OzoNeTT/eis-coursework/img/construction-top.jpg

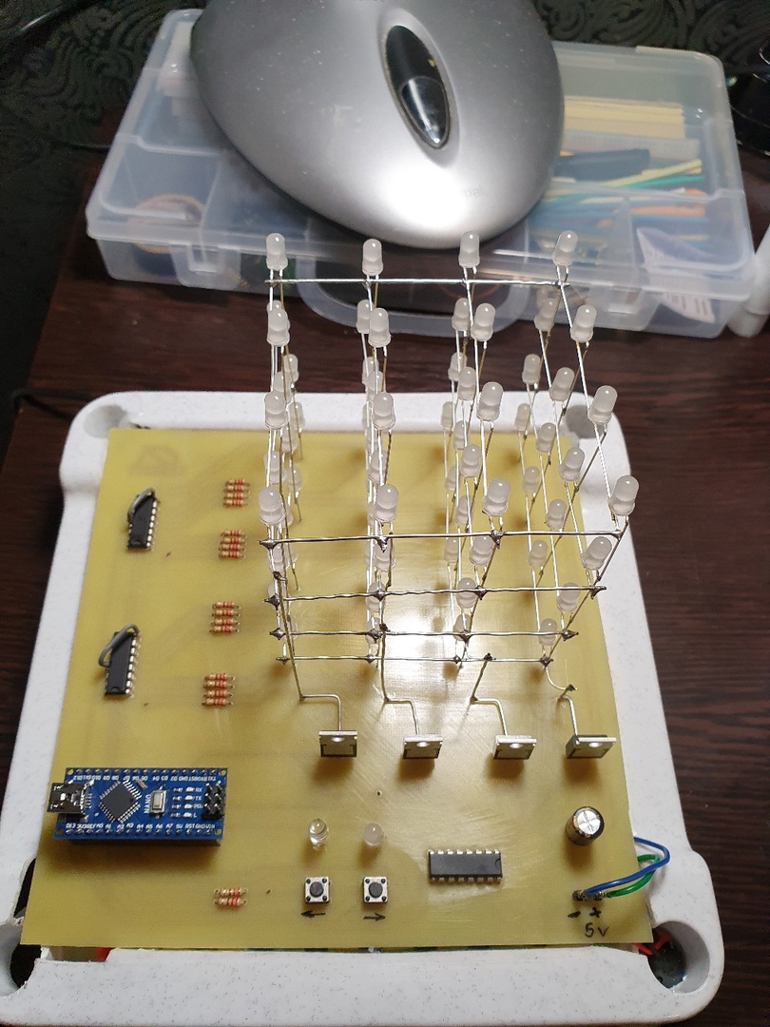
img/construction-top.jpg
