OzoNeTT/eis-coursework/img/construction-bottom.jpg

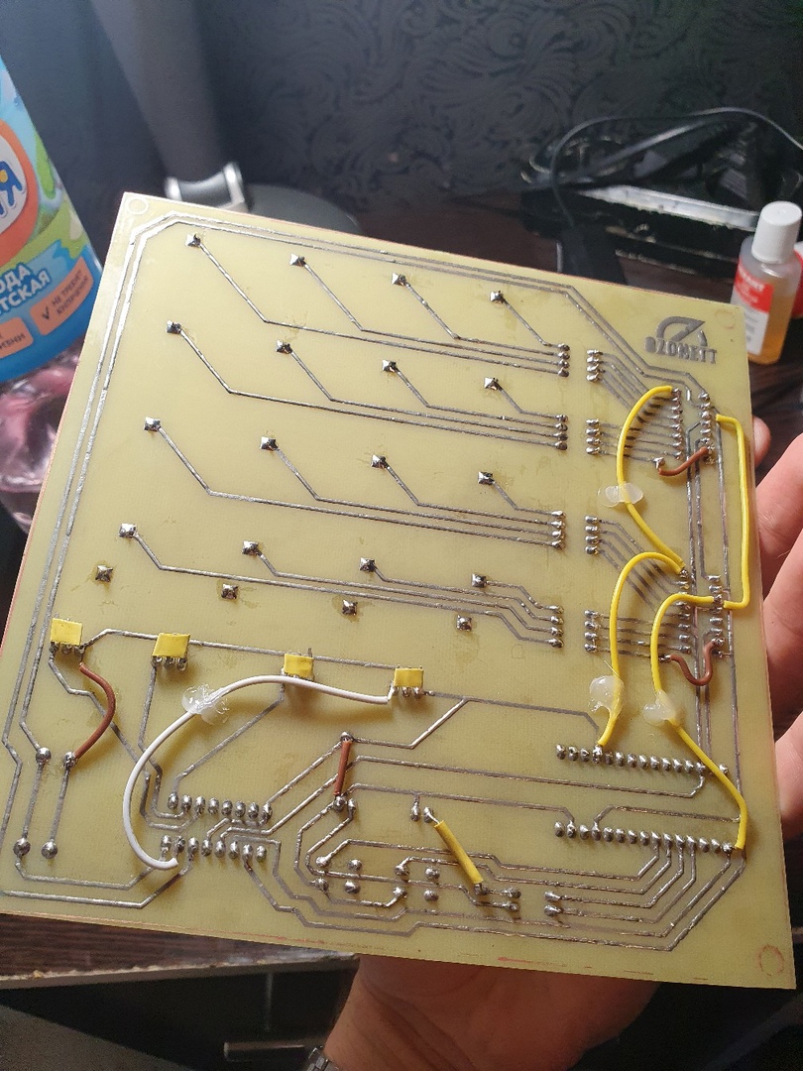
img/construction-bottom.jpg
