OzoNeTT/eis-coursework/README.md

# Курсовой проект по электронике и схемотехнике (6 семестр)

## Использование        

- Открыть редактор [EasyEDA](https://easyeda.com/editor)
- Выбрать "Document" > "Open" > "EasyEDA Source", и выбрать файлы формата `.json`

## Прошивка

Файл прошивки для Arduino Nano v3 расположен в директории `src`

## РПЗ

Расчетно-пояснительная записка расположена в директории `docs`

## Скриншоты 

Все фотографии конструкции и изображения распиновок и плат расположены в директории `img`
