OzoNeTT/eis-coursework/img/body-front.jpg

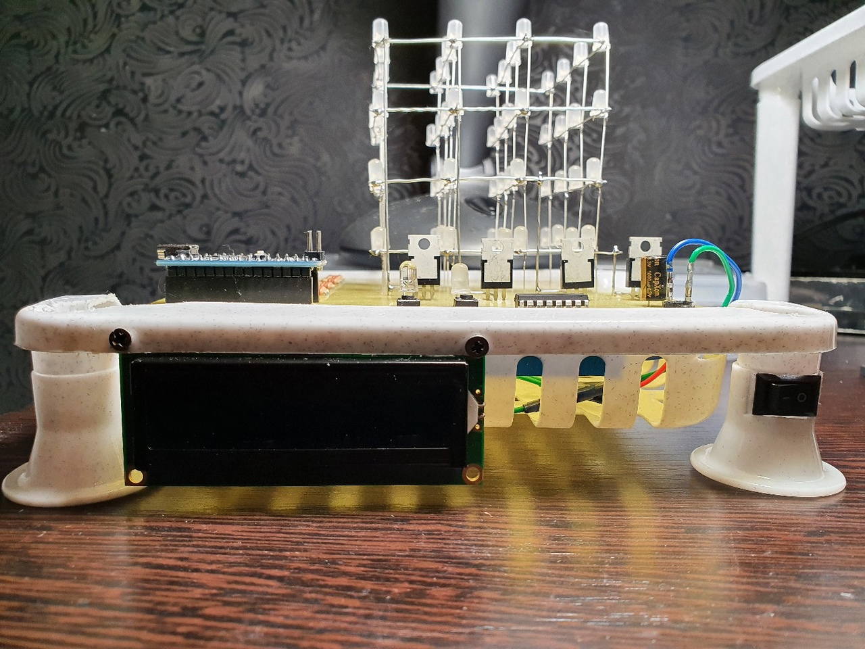
img/body-front.jpg
