OzoNeTT/eis-coursework/img/cube2.jpg

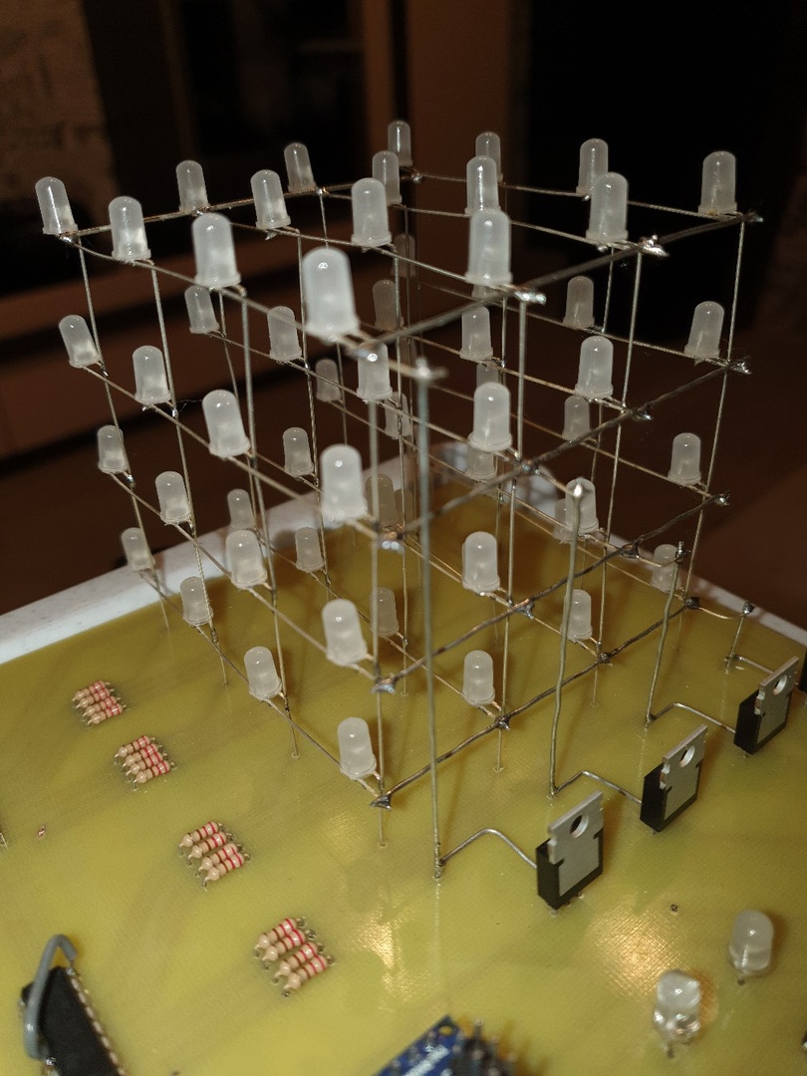
img/cube2.jpg
