OzoNeTT/eis-coursework/img/cube.jpg

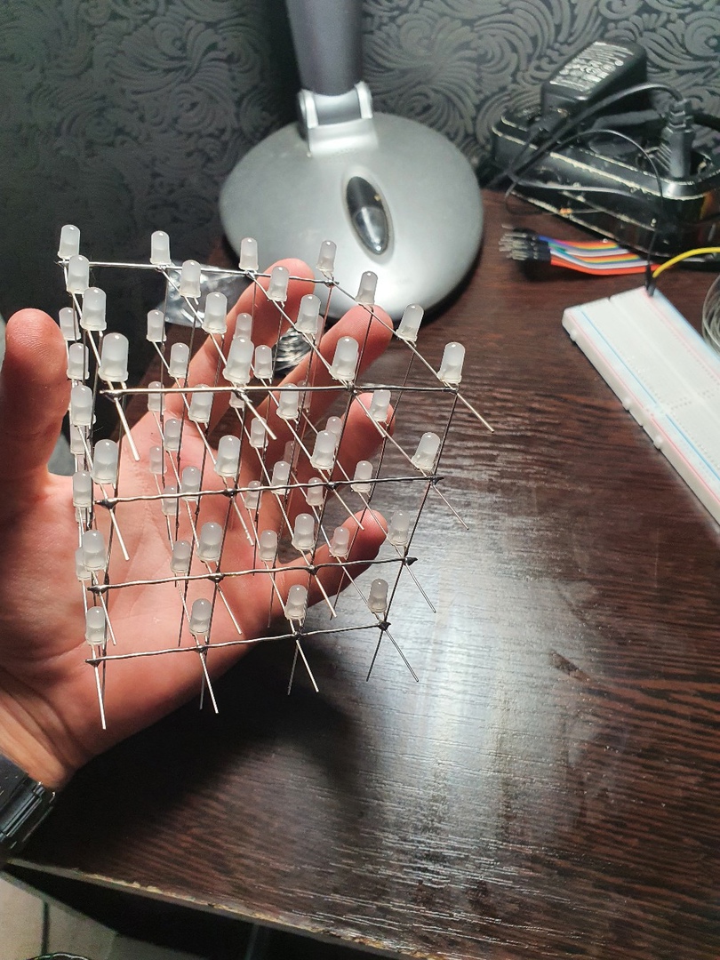
img/cube.jpg
