OzoNeTT/eis-coursework/img/final-view.jpg

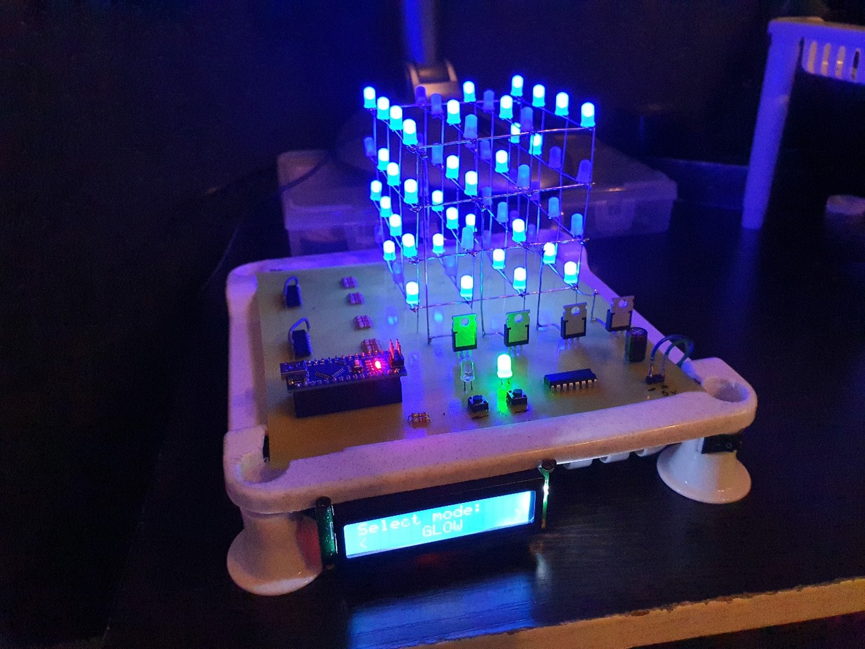
img/final-view.jpg
