OzoNeTT/eis-coursework/img/leds.png

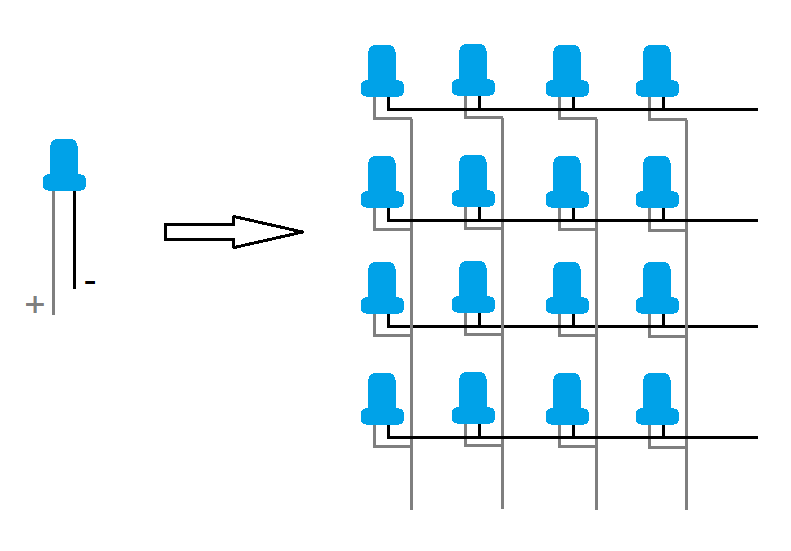
img/leds.png
