OzoNeTT/eis-coursework/img/main-circuit.png

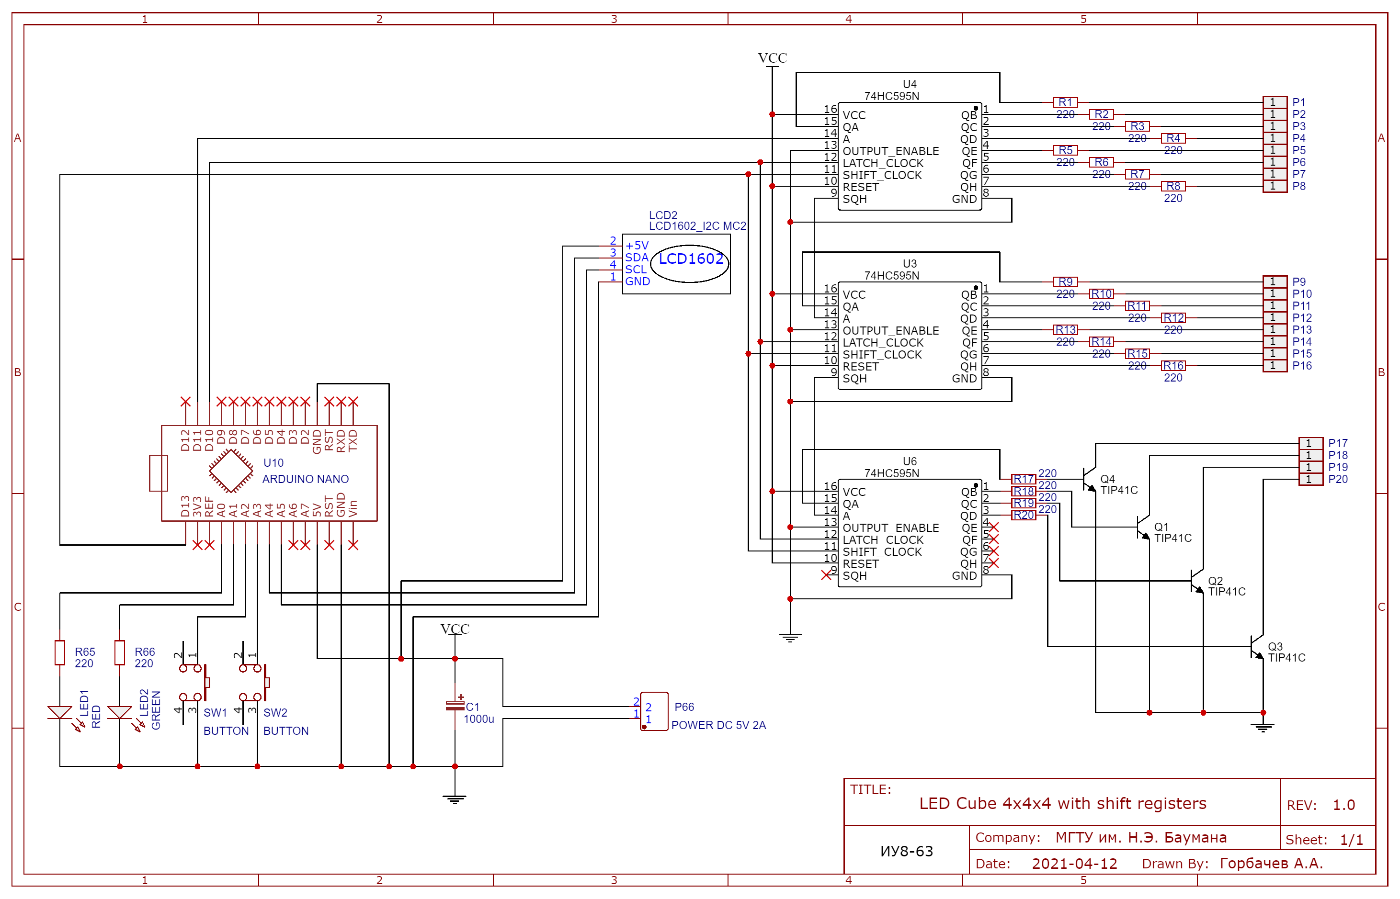
img/main-circuit.png
