OzoNeTT/eis-coursework/img/nano-pinout.png

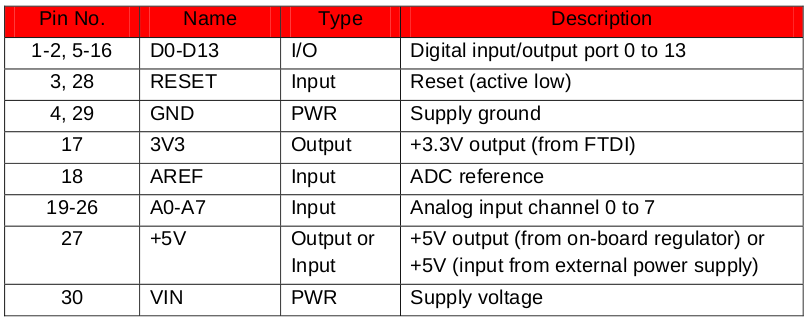
img/nano-pinout.png
