OzoNeTT/eis-coursework/img/nano-shema.png

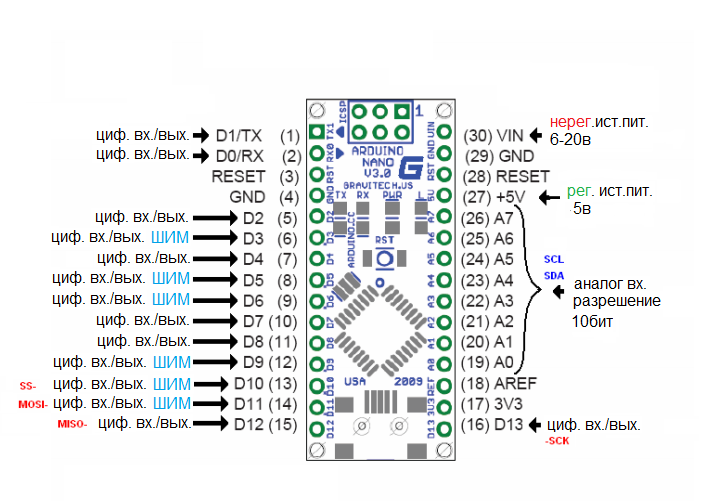
img/nano-shema.png
