OzoNeTT/eis-coursework/img/pcb1.jpg

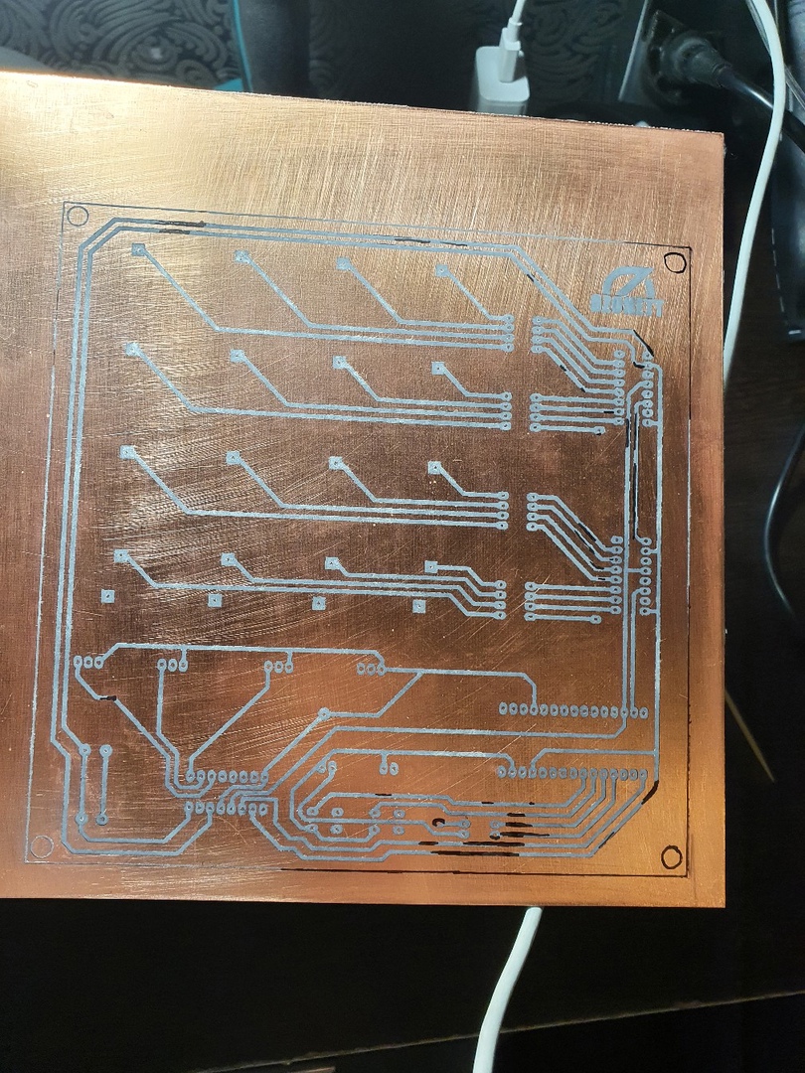
img/pcb1.jpg
