OzoNeTT/eis-coursework/img/pcb2.jpg

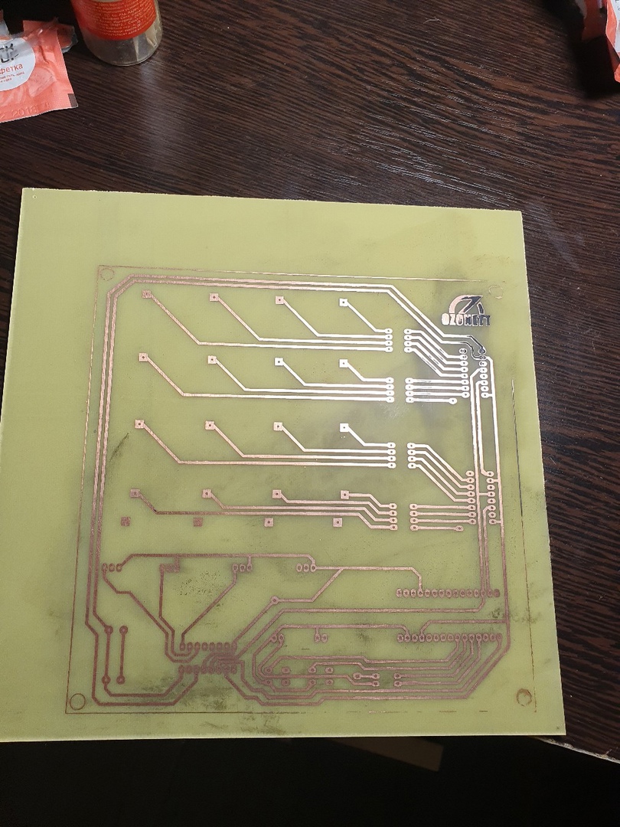
img/pcb2.jpg
