OzoNeTT/eis-coursework/img/pcb3.jpg

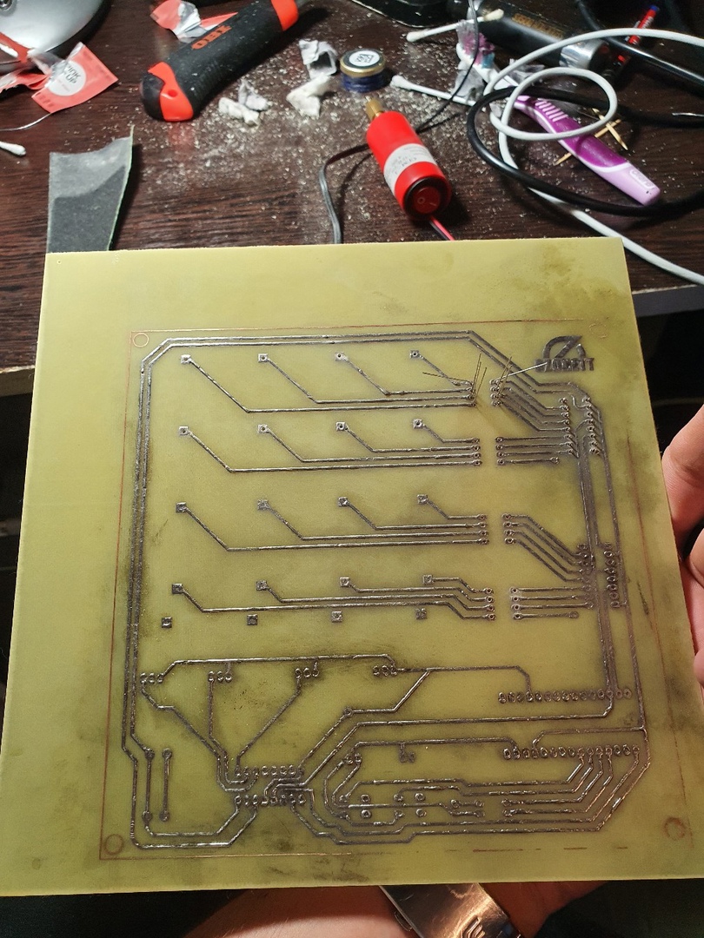
img/pcb3.jpg
