OzoNeTT/eis-coursework/img/pcb-top.png

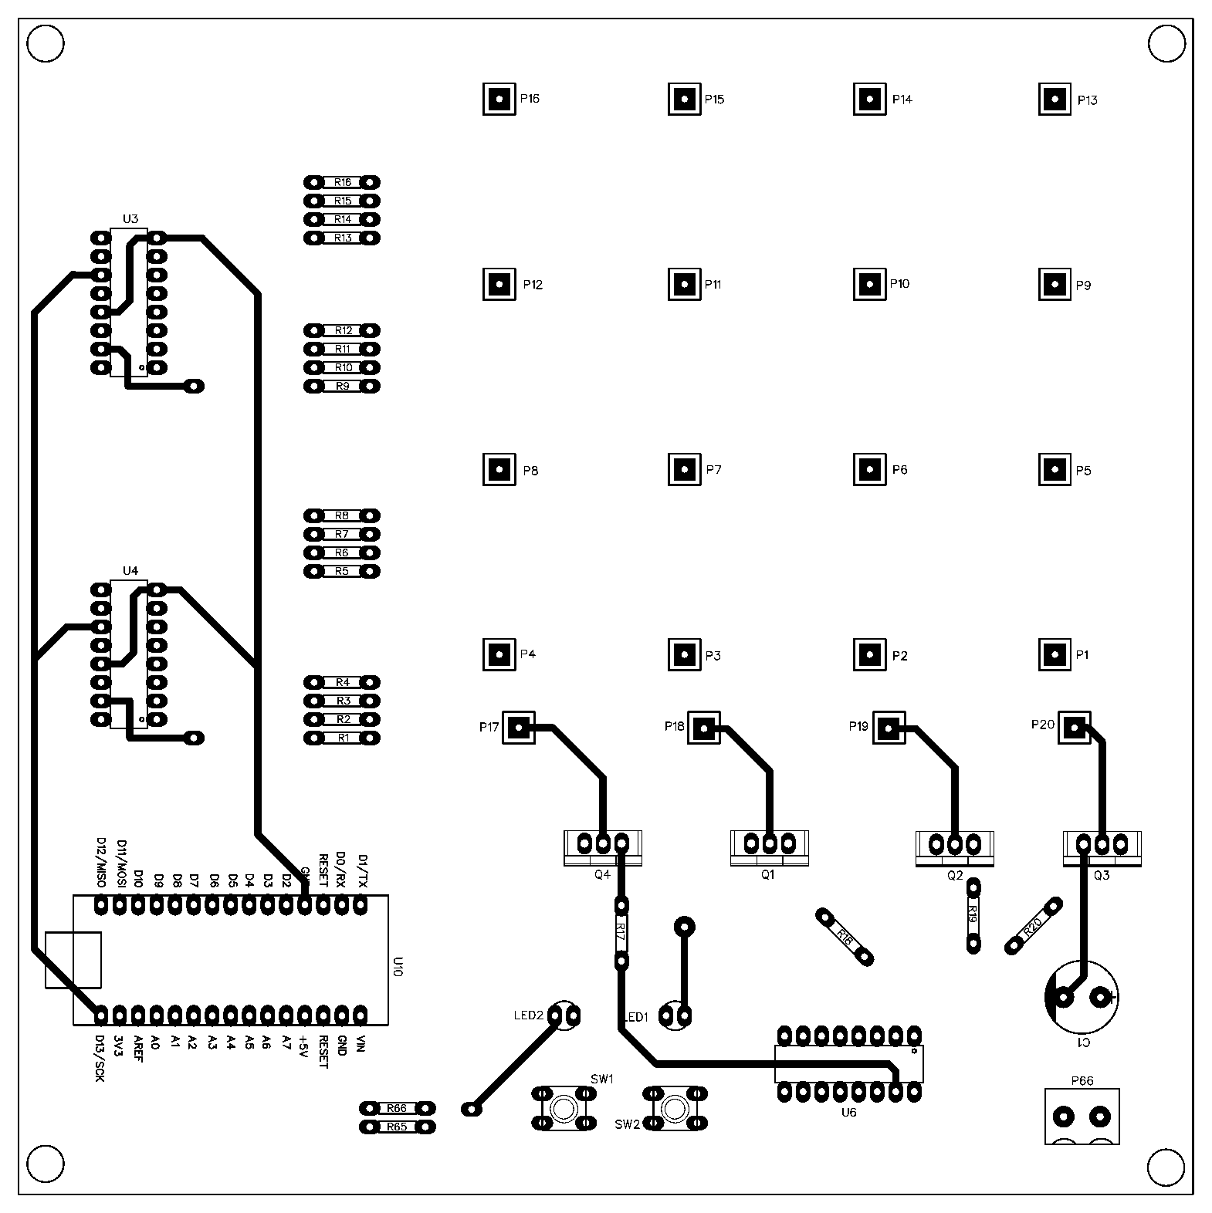
img/pcb-top.png
