OzoNeTT/eis-coursework/(commit log)

2021-05-22 Add schematics
2021-05-22 Add resistors
